JuanPinheiroFIAP/cp2-carrinho--tinyml/(commit log)

2026-09-24 feat(uno): sketches da versao 1 com Arduino Uno
2026-09-24 feat(esp32): carrinho com ESP32 e controle de PS4, mais alternativas por Wi-Fi e Bluetooth
2026-09-24 feat(tinyml): dados, scripts e modelo do Edge Impulse, sketches e carrinho com IA
    [captura_longe.csv, captura_medio.csv, captura_perto.csv, captura_transicao.csv, dataset_distancia.csv]
2026-09-24 chore: remove as pastas de teste e ajusta a documentacao
2026-09-29 docs: integrantes do grupo e print do Classifier com nome do projeto
2026-09-29 feat(esp32): buzzer no GPIO 4 (alerta de obstaculo/emergencia) e buzina no R3
    [carrinho_esp32_ps4_ia.ino]
